NilujePerchut/doppelgangerV2/README.md

# Doppelganger V2 RevA0

## Requirements:

### Hardware:
* Kicad 5+
* python3
* skidl

### Software:
