NilujePerchut/doppelgangerV2/hard/BlockDiagram.png

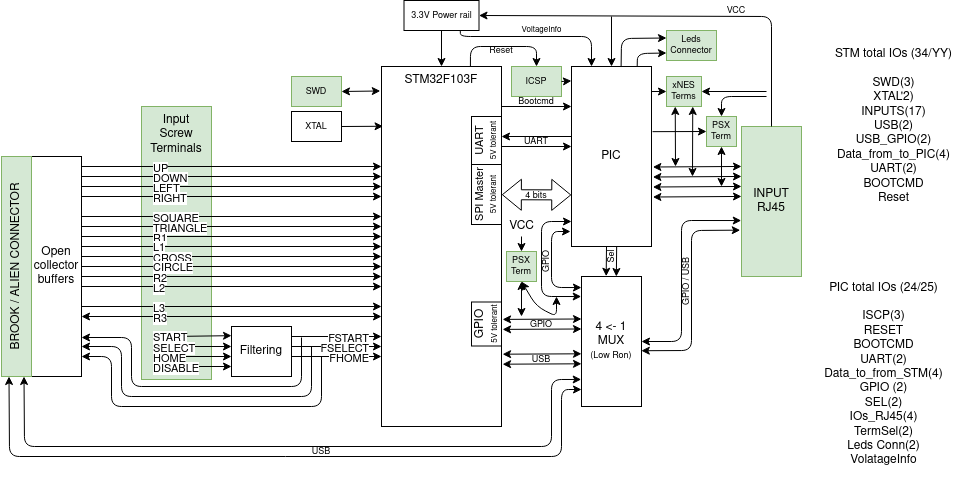
hard/BlockDiagram.png
