NilujePerchut/doppelgangerV2/hard/datasheets/brook_fighting_board.jpg

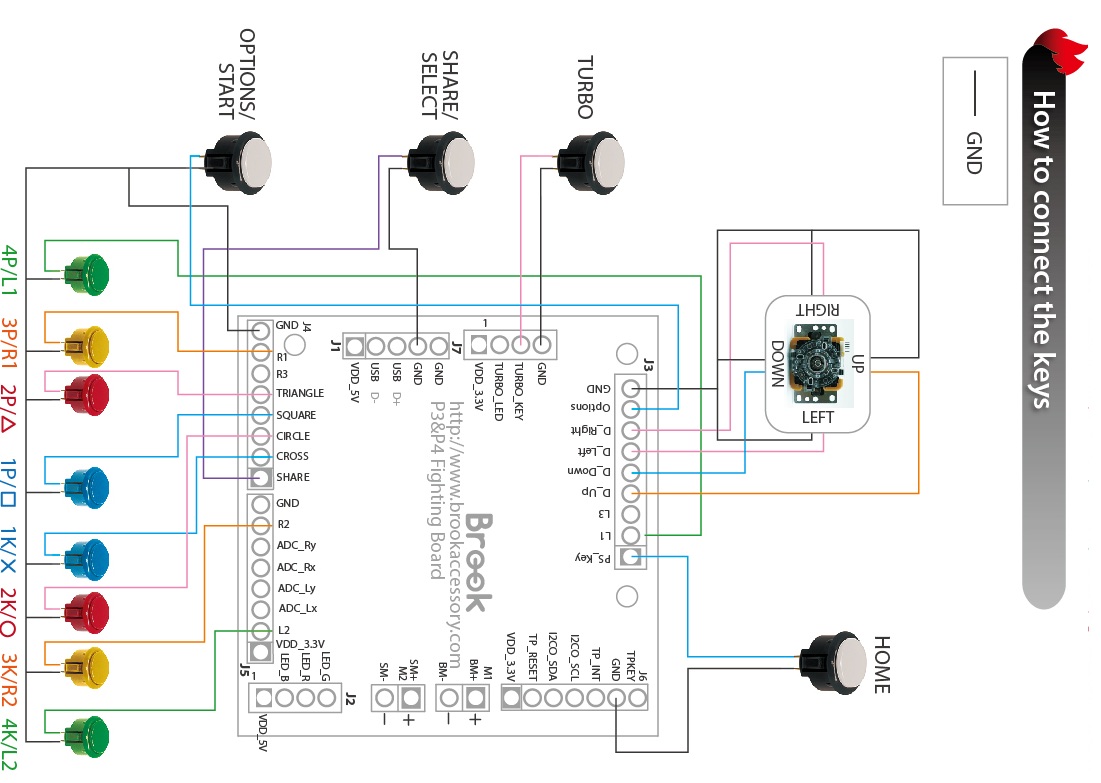
hard/datasheets/brook_fighting_board.jpg
