NilujePerchut/doppelgangerV2/hard/main_board/pcb/fab/JLCPCB_comms/good.png

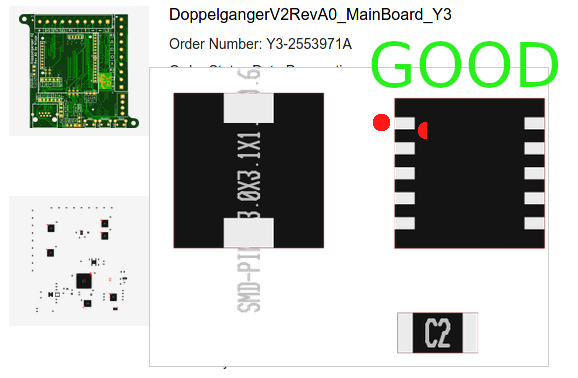
hard/main_board/pcb/fab/JLCPCB_comms/good.png
