NilujePerchut/doppelgangerV2/hard/main_board/pcb/fab/JLCPCB_comms/wrong.png

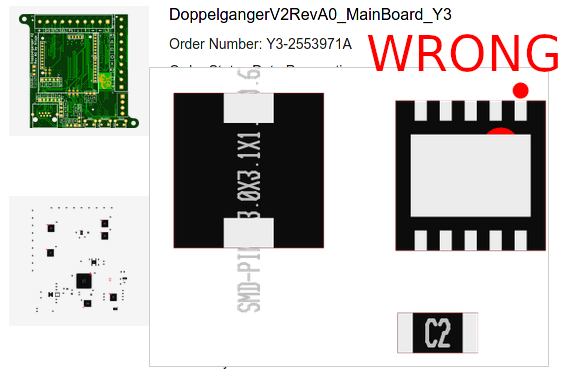
hard/main_board/pcb/fab/JLCPCB_comms/wrong.png
