NilujePerchut/doppelgangerV2/hard/main_board/pcb/main_board.kicad_pcb

## KiCad design hard/main_board/pcb/main_board.kicad_pcb (2022-08-13)

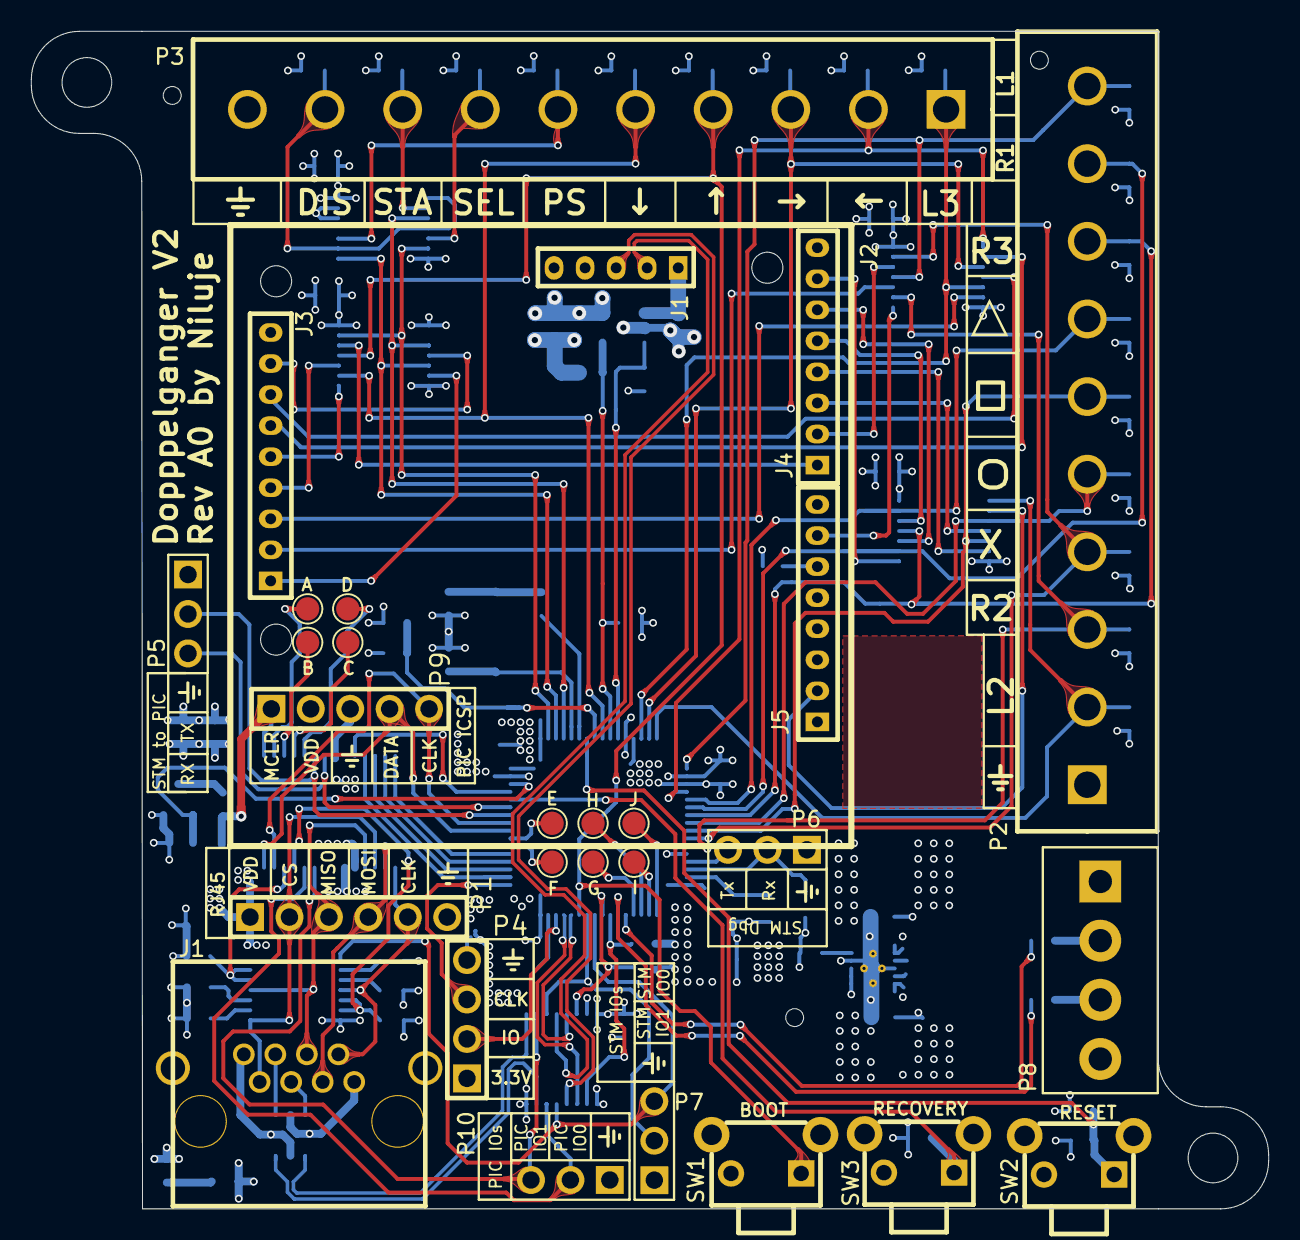
[picture p5: board main_board.kicad_pcb from above]

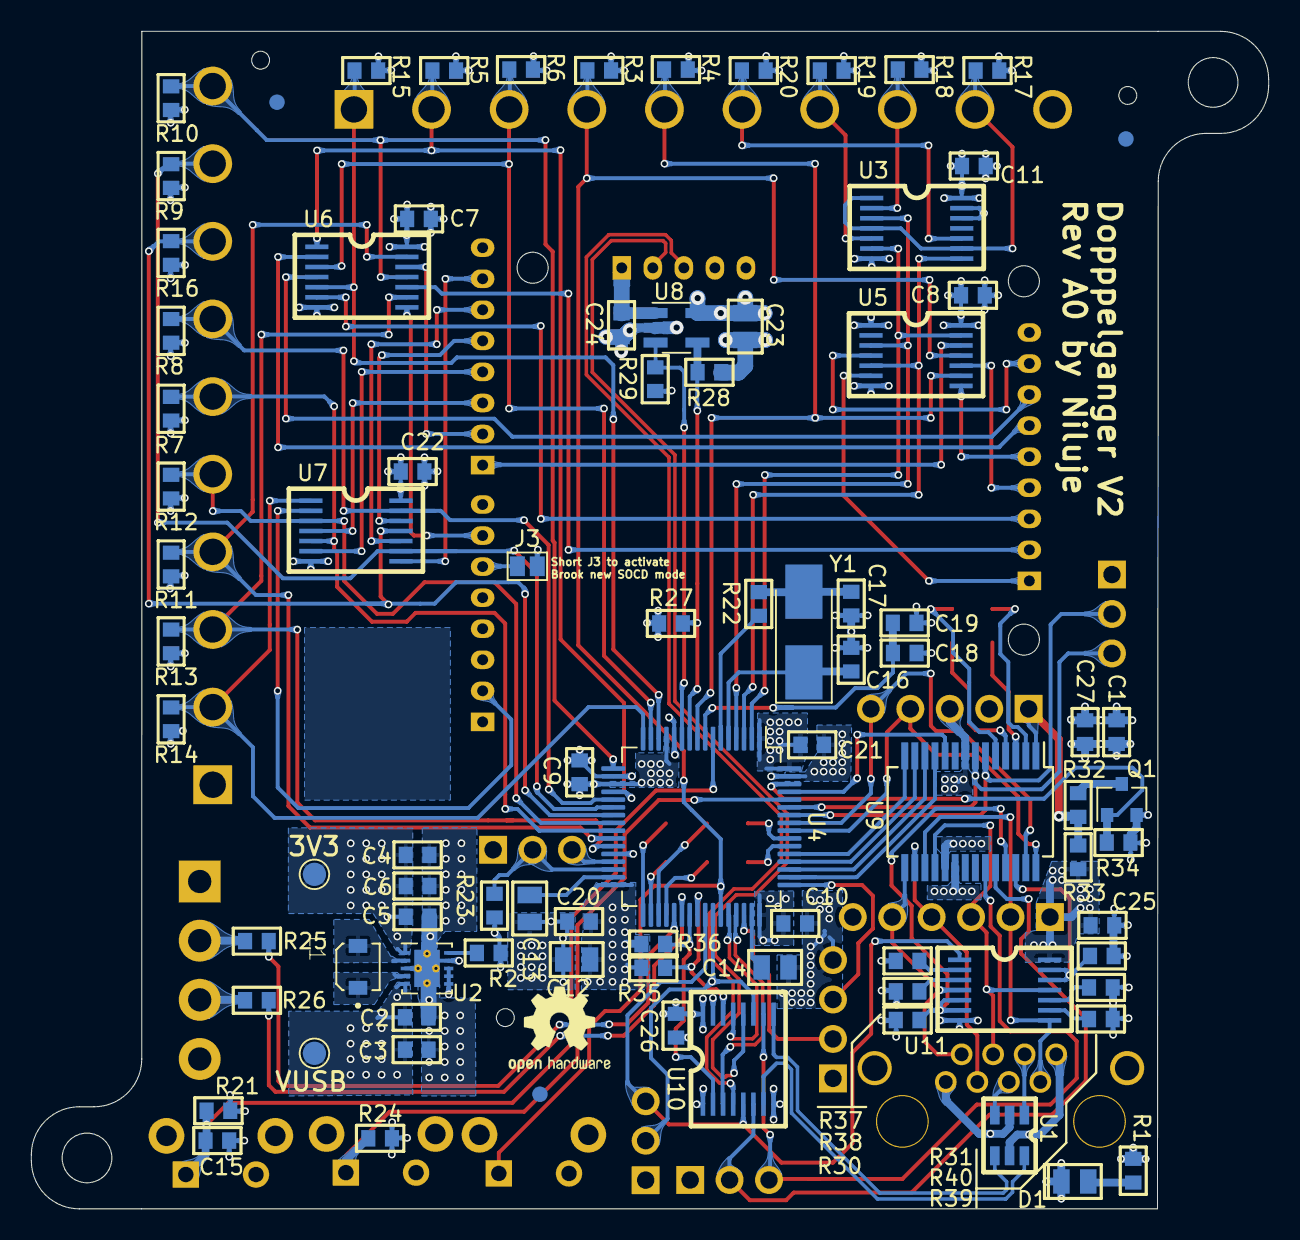
[picture p6: board main_board.kicad_pcb from below]

Board: 4 copper layers, 79.7 x 75.8 mm, 120 parts (89 on the bottom side), 111 nets.

Parts:
C1, C7, C8, C9, C10, C11, C15, C20, C21, C22, C24, C25, C26, C27: 100nF; 0603C
C2, C3, C4, C5, C6: 10uF; 0603C
C12: 4.7uF; 0805C
C13, C14: 2.2uF; 0805C
C16, C17: 30pF; 0603C
C18, C19: 10K; 0603C
C23: 1uF; 0805C
D1: LED; 0805LED
F1, F2: Fix; FIX
F3, F4, F5: Fix; JLCPCB_TOOLING_HOLE
FID1, FID2, FID3: FIDUCIAL
J1: RJ45
J2: BROOK_FB
J3: GS2
L1: L; 1227AS-H-1R5N=P2
P1: CONN_01X06; SIL6
P2, P3: BORNIER_10
P4: CONN_01X04; SIL4
P5, P6, P7, P10: CONN_01X03; SIL3
P8: CONN_01X04; Bornier4_3.81mm
P9: CONN_01X05; SIL5
Q1: Q_NMOS_DGS; SOT23
R1: 120.0; 0603R
R2, R22: 0R; 0603R
R3, R4, R5, R6, R7, R8, R9, R10, R11, R12, R13, R14, R15, R16, R17, R18, R19, R20, R21, R23, R27, R28, R29, R34, R35, R36: 10K; 0603R
R24: 100K; 0603R
R25, R26, R30, R31: 330R; 0603R
R32: 100R; 0603R
R33: 12K5; 0603R
R37, R40: 4K7; 0603R
R38, R39: 3K6; 0603R
S1, S2: Sakura; Sakura_solder_mask
SW1, SW2, SW3: SW_PUSH; BP
TP1, TP2, TP3, TP4, TP5, TP6, TP7, TP8, TP9, TP10, TP11, TP12: TestPoint; TestPoint_Pad_D1.5mm
U1: USBLC6-2SC6; TSOT-23-6
U2: TPS63000; Texas_DRC0010J_ThermalVias
U3: 74HC32; TSSOP14
U4: STM32F405RGTx; LQFP-64_10x10mm_P0.5mm
U5, U6, U7: 74LVC07; TSSOP14
U8: USBPowerSwitch; SOT23-5
U9: 16F18855; SSOP-28_5.3x10.2mm_P0.65mm
U10: SN74CBT3253; TSSOP16
U11: 74HC4066; TSSOP14
Y1: Crystal; Crystal_SMD_5032-2Pin_5.0x3.2mm_HandSoldering

Connections:
BOOT0: R24.1, SW3.1, U4.60
BROOK_POWER_CMD: R27.2, R28.2, U4.10, U8.4
BROOK_POWER_FAULTN: R29.2, U4.11, U8.3
BROOK_USB_N: J2.J1_2, U10.12
BROOK_USB_P: J2.J1_3, U10.4
CIRCLE: P2.5, R12.2, U4.24, U7.3
CIRCLE_BROOK: J2.J4_3, U7.4
CROSS: P2.4, R11.2, U4.26, U6.13
CROSS_BROOK: J2.J4_2, U6.12
DBG_RX: P6.2, R23.2, U4.30
DBG_TX: P6.3, U4.29
DISABLE: P3.9, R17.2, U3.1, U3.4, U3.9
DOWN: P3.5, R4.2, U4.9, U5.9
DOWN_BROOK: J2.J3_5, U5.8
GND: C1.2, C2.2, C3.2, C4.2, C5.2, C6.2, C7.2, C8.2, C9.2, C10.2, C11.2, C12.2, C13.2, C14.2, C15.2, C16.2, C17.2, C19.2, C20.2, C21.2, C22.2, C23.2, C24.2, C25.2, C26.2, C27.2, D1.K, J1.1, J2.J1_4, J2.J1_5, J2.J3_9, J2.J4_8, J2.J5_8, J3.2, P1.6, P2.1, P3.10, P4.4, P5.1, P6.1, P7.1, P8.4, P9.3, P10.1, Q1.2, R24.2, R28.1, R30.1, R31.1, R34.1, SW1.2, SW2.2, U1.2, U2.3, U2.9, U2.11, U3.7, U3.12, U3.13, U4.12, U4.18, U4.28, U4.63, U5.7, U6.7, U7.7, U8.2, U9.8, U9.19, U10.1, U10.8, U10.15, U11.7
GPIO0_UPPER_TERM_SW: R37.2, U11.2
HOME: P3.6, R20.2, U3.10
HOME_BROOK: J2.J3_1, U5.6
HOME_FILTERED: U3.8, U4.3, U5.5
L1: P2.10, R10.2, U4.17, U6.11
L1_BROOK: J2.J3_2, U6.10
L2: P2.2, R14.2, U4.16, U7.1
L2_BROOK: J2.J5_2, U7.2
L3: P3.1, R15.2, U4.14, U6.5
L3_BROOK: J2.J3_3, U6.6
LED_L: R25.1, U4.37
LED_R: R26.1, U4.38
LEFT: P3.2, R5.2, U4.20, U6.1
LEFT_BROOK: J2.J3_6, U6.2
MCLR: P9.1, R32.2, R33.2, U9.1
unnamed: D1.A, R1.2
unnamed: J1.5, U1.3
unnamed: J1.6, U1.1
unnamed: R2.2, U2.10
unnamed: L1.1, U2.4
unnamed: L1.2, U2.2
unnamed: C13.1, U4.31
unnamed: C14.1, U4.47
unnamed: C17.1, R22.2, Y1.2
unnamed: P8.2, R25.2
unnamed: P8.3, R26.2
unnamed: C18.2, C19.1, U4.8
unnamed: TP3.1, U4.55
unnamed: TP4.1, U4.33
unnamed: TP5.1, U4.34
unnamed: TP6.1, U4.35
unnamed: TP7.1, U4.36
unnamed: TP8.1, U4.54
unnamed: J2.J5_6, J3.1
unnamed: Q1.3, R32.1
unnamed: TP9.1, U9.2
unnamed: TP10.1, U9.3
unnamed: TP11.1, U9.4
unnamed: TP12.1, U9.5
R1: P2.9, R9.2, U4.22, U7.9
R1_BROOK: J2.J4_7, U7.8
R2: P2.3, R13.2, U4.27, U6.9
R2_BROOK: J2.J5_7, U6.8
R3: P2.8, R16.2, U4.23, U7.11
R3_BROOK: J2.J4_6, U7.10
RIGHT: P3.3, R6.2, U4.15, U6.3
RIGHT_BROOK: J2.J3_7, U6.4
RJ45_USB_N: U1.4, U10.9
RJ45_USB_P: U1.6, U10.7
RJ_SPI_CLK: J1.2, P1.5, U9.15, U11.4
RJ_SPI_CLK_UPPER_TERM_SW: R38.2, U11.3
RJ_SPI_CS: J1.7, P1.2, U9.17, U11.8
RJ_SPI_CS_UPPER_TERM_SW: R39.2, U11.9
RJ_SPI_MISO: J1.4, P1.3, U9.18, U11.11
RJ_SPI_MISO_UPPER_TERM_SW: R40.2, U11.10
RJ_SPI_MOSI: J1.3, P1.4, U9.16
SELECT: P3.7, R19.2, U3.5
SELECT_BROOK: J2.J4_1, U5.12
SELECT_FILTERED: U3.6, U4.2, U5.13
SQUARE: P2.6, R7.2, U4.25, U7.5
SQUARE_BROOK: J2.J4_4, U7.6
START: P3.8, R18.2, U3.2
START_BROOK: J2.J3_8, U5.4
START_FILTERED: U3.3, U4.4, U5.3
STM32_RESETn: C15.1, R21.2, SW2.1, U4.7
STM32_USB_N: U4.44, U10.13
STM32_USB_P: U4.45, U10.3
STM_TO_PIC_BOOT_CMD: U4.61, U9.10
STM_TO_PIC_DATA0: U4.50, U9.11
STM_TO_PIC_DATA1: U4.51, U9.12
STM_TO_PIC_DATA2: U4.52, U9.13
STM_TO_PIC_DATA3: U4.53, U9.14
STM_TO_PIC_ICSP_CLOCK: P9.5, U4.57, U9.27
STM_TO_PIC_ICSP_DATA: P9.4, U4.56, U9.28
STM_TO_PIC_RESET: Q1.1, R34.2, U4.62
STM_TO_PIC_UART_RX: P5.3, U4.59, U9.7
STM_TO_PIC_UART_TX: P5.2, U4.58, U9.6
SWDCLK: P4.3, U4.49
SWDIO: P4.2, U4.46
TRIANGLE: P2.7, R8.2, U4.21, U7.13
TRIANGLE_BROOK: J2.J4_5, U7.12
UP: P3.4, R3.2, SW1.1, U4.43, U5.11
UP_BROOK: J2.J3_4, U5.10
V5_SW: C24.1, J2.J1_1, U8.1
V33: C4.1, C5.1, C6.1, C7.1, C8.1, C9.1, C10.1, C11.1, C12.1, C20.1, C21.1, C22.1, C26.1, P4.1, P8.1, R2.1, R3.1, R4.1, R5.1, R6.1, R7.1, R8.1, R9.1, R10.1, R11.1, R12.1, R13.1, R14.1, R15.1, R16.1, R17.1, R18.1, R19.1, R20.1, R21.1, R23.1, R27.1, R35.1, R36.1, R37.1, SW3.2, TP2.1, U2.1, U3.14, U4.1, U4.13, U4.19, U4.32, U4.48, U4.64, U5.1, U5.14, U6.14, U7.14, U10.16
VUSB: C1.1, C2.1, C3.1, C18.1, C23.1, C25.1, C27.1, J1.8, P1.1, P9.2, R1.1, R29.1, R33.1, R38.1, R39.1, R40.1, TP1.1, U1.5, U2.5, U2.6, U2.7, U2.8, U8.5, U9.20, U11.14
XTAL_IN: C16.1, U4.5, Y1.1
XTAL_OUT: R22.1, U4.6
mux_sel0: R35.2, U4.40, U10.14
mux_sel1: R36.2, U4.39, U10.2
pic16_gpio0: P10.2, U9.24, U10.6
pic16_gpio1: P10.3, U9.23, U10.10
psx_term_cmd: R31.2, U9.26, U11.12, U11.13
snes_term_cmd: R30.2, U9.25, U11.5, U11.6
stm32_gpio0: P7.3, U4.41, U10.5, U11.1
stm32_gpio1: P7.2, U4.42, U10.11
