NilujePerchut/doppelgangerV2/soft/arm/hardware_validation/src/adc.c

#include <libopencm3/stm32/adc.h>
#include <libopencm3/stm32/gpio.h>
#include <libopencm3/stm32/rcc.h>
#include "adc.h"

void init_adc(void)
{
	rcc_periph_clock_enable(RCC_GPIOC);
	rcc_periph_clock_enable(RCC_ADC1);
	gpio_mode_setup(GPIOC, GPIO_MODE_ANALOG, GPIO_PUPD_NONE, GPIO0);

	adc_power_off(ADC1);
	adc_disable_scan_mode(ADC1);
	adc_set_sample_time_on_all_channels(ADC1, ADC_SMPR_SMP_3CYC);
	adc_power_on(ADC1);
}


uint16_t read_adc_vio(void)
{
	uint8_t channel_array[16];
	channel_array[0] = ADC_VIO_CHANNEL;
	adc_set_regular_sequence(ADC1, 1, channel_array);
	adc_start_conversion_regular(ADC1);
	while (!adc_eoc(ADC1));
	uint16_t reg16 = adc_read_regular(ADC1);
	return reg16;
}
