NilujePerchut/doppelgangerV2/(commit log)

2022-08-13 [HARD] Doppenganger V2 RevA0 PCB
    [DoppelgangerV2RevA0_Board_BOM_.csv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]
2022-08-13 [SOFT] Add arm bootloader & black magic probe bins
2022-08-13 [SOFT] Add arm soft part
2022-08-13 [SOFT] Updates main board hardware validation plan
2022-10-09 Main board hardware validation done
    SNES POC OK
2022-10-22 [SOFT] Create Doppelganger ARM app with keys subsystem
    Includes Unit tests (first version)
    Keys need to access the config
    Working Keys
